dct00678/ALU-HALF/BOM.csv

Part Name | Quantity | Value | Description | Footprint | Datasheet | Avg Unit Price (USD) | Line Total (USD) | Avg Unit Price (PHP) | Line Total (PHP)
C1 | 1 | 220µF | Electrolytic capacitor, 16V, radial (bulk, +5V rail) |  |  | 0.25 | 0.25 | 15.50 | 15.50
C2,C3 | 2 | 0.1µF | Ceramic capacitor, 50V (decoupling) |  |  | 0.10 | 0.20 | 6.20 | 12.40
D1,D2 | 2 | LED Red 5mm | Red LED, 5mm (D1 = SUM, D2 = C_OUT) |  |  | 0.15 | 0.30 | 9.30 | 18.60
Q1,Q2 | 2 | PN2222A | NPN transistor, TO-92 (E-B-C pinout) | Package_TO_SOT_THT:TO-92_Inline | https://www.onsemi.com/pub/Collateral/PN2222-D.PDF | 0.30 | 0.60 | 18.60 | 37.20
R1,R2,R3,R4 | 4 | 20K Ω | Resistor 1/4W |  |  | 0.05 | 0.20 | 3.10 | 12.40
R5,R6 | 2 | 220 Ω | Resistor 1/4W |  |  | 0.05 | 0.10 | 3.10 | 6.20
SW1,SW2 | 2 | SS12F17 | SPDT slide switch (inputs A, B) |  |  | 0.85 | 1.70 | 52.70 | 105.40
U1 | 1 | 74LS86 | Quad 2-input XOR gate, DIP-14 | Package_DIP:DIP-14_W7.62mm | https://www.jameco.com/Jameco/Products/ProdDS/48098.pdf | 0.32 | 0.32 | 20.00 | 20.00
U2 | 1 | 74LS08 | Quad 2-input AND gate, DIP-14 | Package_DIP:DIP-14_W7.62mm | http://www.ti.com/lit/gpn/sn74LS08 | 0.32 | 0.32 | 20.00 | 20.00
TOTAL |  |  |  |  |  |  | 3.99 |  | 247.70
