dct00678/ALU-HALF/Schematic/half_adder.pdf

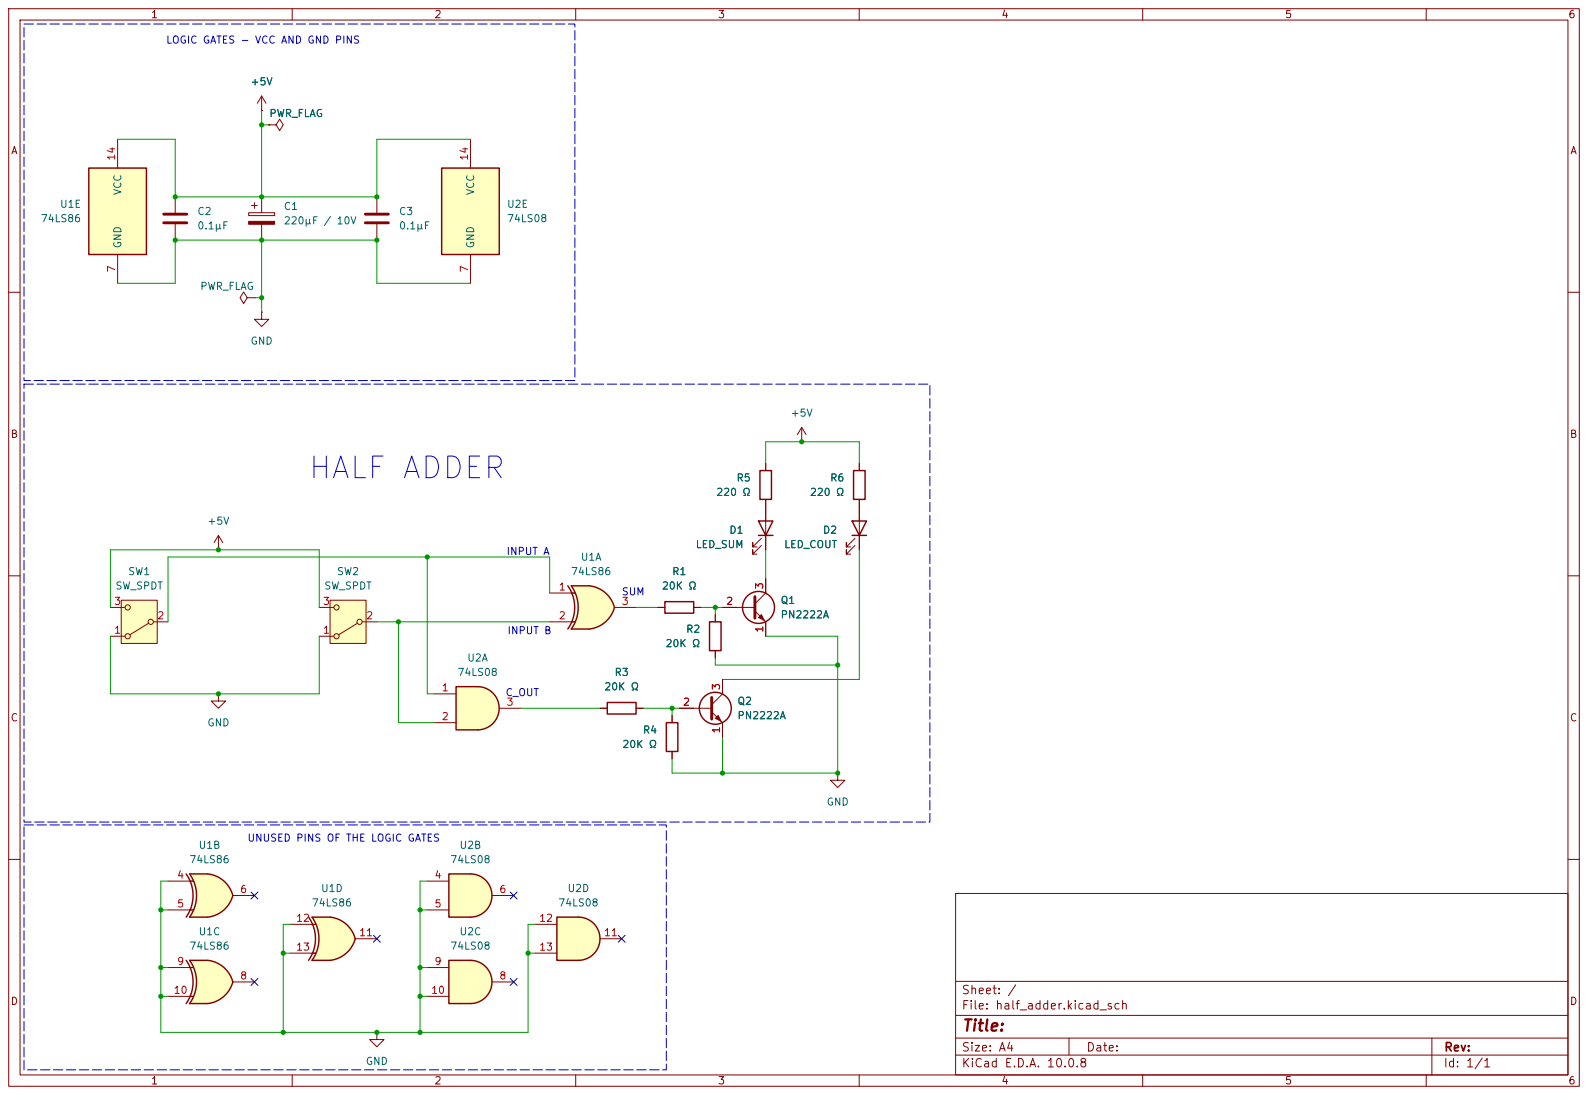
[picture p1: page 1]

LOGIC GATES - VCC AND GND PINS HALF ADDER

UNUSED PINS OF THE LOGIC GATES 6 U1B 74LS86 | 6 U2B

Size: A4 | Rev:
KiCad E.D.A. 10.0.8 | Id: 1/1
