dct00678/ALU-HALF/Schematic/half_adderrr.kicad_sch

## KiCad design Schematic/half_adderrr.kicad_sch (2026-11-11)

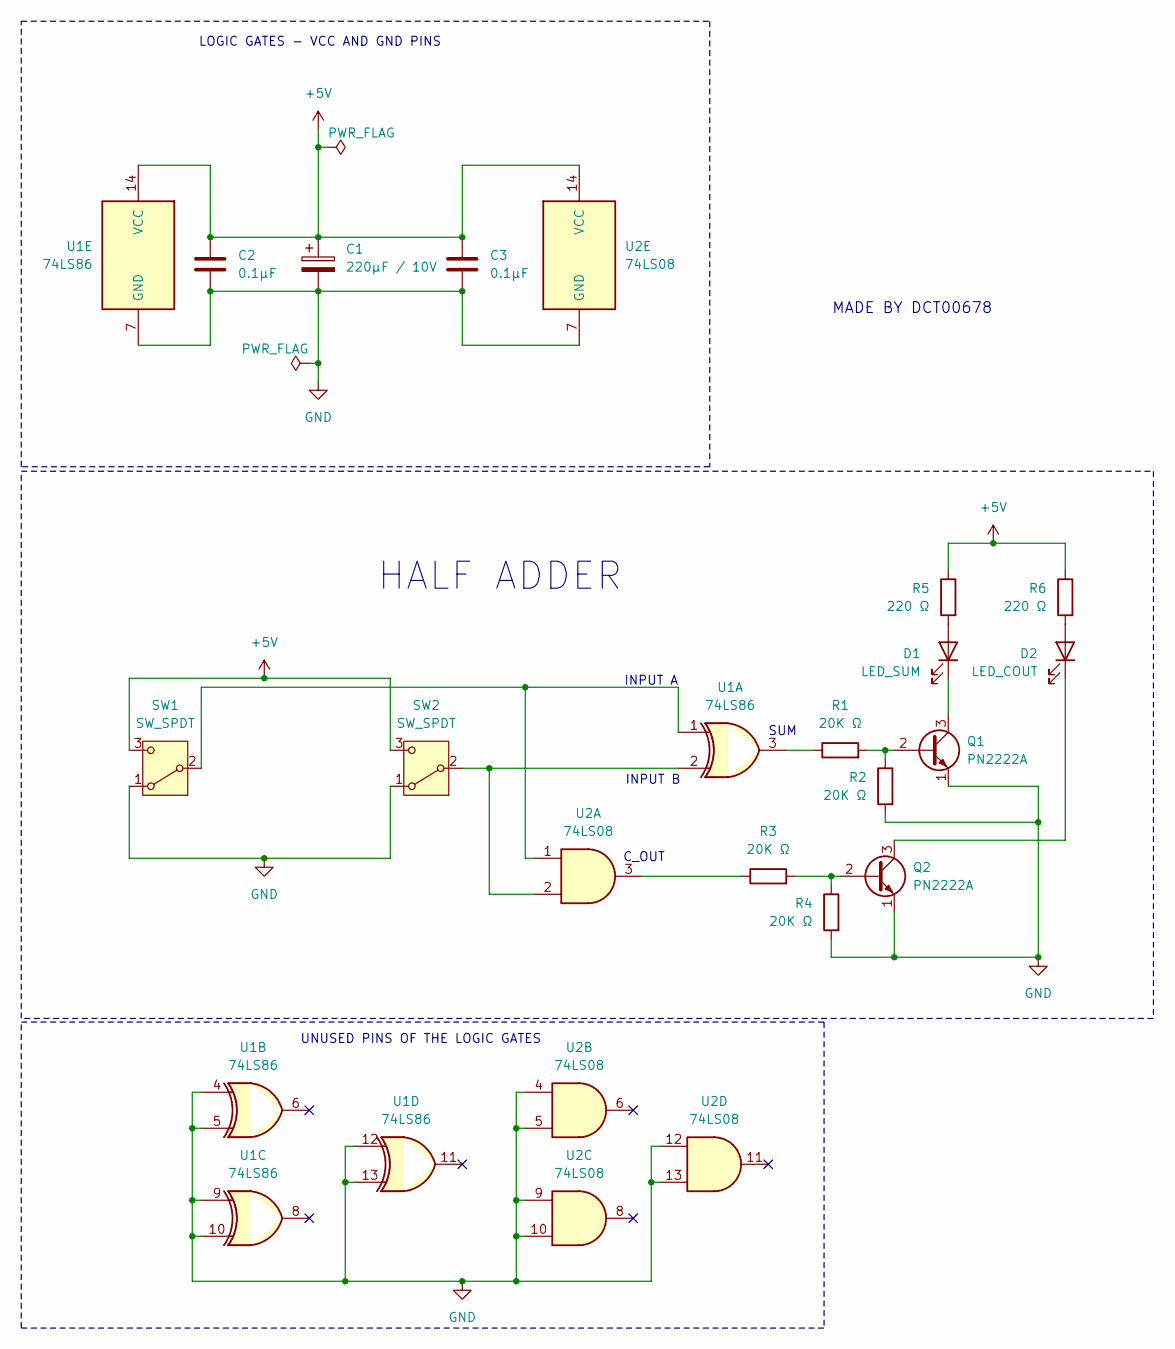
[picture p2: schematic half_adderrr.kicad_sch]

Parts:
C1: 220µF / 10V
C2, C3: 0.1µF
D1: LED_SUM
D2: LED_COUT
Q1, Q2: PN2222A; TO-92_Inline
R1, R2, R3, R4: 20K Ω
R5, R6: 220 Ω
SW1, SW2: SW_SPDT
U1: 74LS86
U2: 74LS08

Connections:
+5V: C1.1, C2.1, C3.1, R5.1, R6.1, SW1.3 (C), SW2.3 (C), U1.14 (VCC), U2.14 (VCC)
GND: C1.2, C2.2, C3.2, Q1.1 (E), Q2.1 (E), R2.2, R4.2, SW1.1 (A), SW2.1 (A), U1.4, U1.5, U1.7 (GND), U1.9, U1.10, U1.12, U1.13, U2.4, U2.5, U2.7 (GND), U2.9, U2.10, U2.12, U2.13
unnamed: D1.1 (K), Q1.3 (C)
unnamed: D1.2 (A), R5.2
unnamed: D2.1 (K), Q2.3 (C)
unnamed: D2.2 (A), R6.2
unnamed: Q1.2 (B), R1.2, R2.1
unnamed: Q2.2 (B), R3.2, R4.1
unnamed: R1.1, U1.3
unnamed: R3.1, U2.3
unnamed: SW1.2 (B), U1.1, U2.1
unnamed: SW2.2 (B), U1.2, U2.2

Notes on the sheet:
SUM
UNUSED PINS OF THE LOGIC GATES
HALF ADDER
MADE BY DCT00678
C_OUT
LOGIC GATES - VCC AND GND PINS
INPUT B
INPUT A
