dct00678/ALU-HALF/JOURNAL.md

---
title: ALU-HALF
author: dct00678
description: "Building a 74LS Half Adder: The Core Foundation of Modern Microcontrollers and ALUs"
created_at: 11-10-2026
---

# November 10 2026 / 🕗 8:20 - 8:40 PM
Started creating the schematic in KiCad cuz the last time that i was building schematics was in EasyEda and well it was REALLY bad!

Made the VCC AND GND connections of each Logic Gate, paired with a 0.1uf Capacitor. 
For the main breadboard power rails, i laid a 220uf / 10V capacitor to act as a bulk decoupling capacitor.

I paired the VCC and GND pins with a capacitor because my power supply is not stable it's being connected on my laptop so it's like a dc-dc, and it serves as a decoupling capacitor for low level voltage noises!

Note: Today i learned that we need to use pwr_flags for the vcc and gnd pin!!


**Total time spent: 20 Minutes**

# November 10 2026 / 🕣 8:45 - 8:50 PM
Added the switches for the inputs of the Half Adder
I used SPDT Switches so when a another person builds this, they can manually change the state of each input. (I HATE USING PUSHBUTTONS!!)

SW = Switches

SW1 = Input A
SW2= Input B



**Total time spent: 10 Minutes**

# November 10 2026 / 🕣 8:55 - 9:25 pm

Built the 74LS Logic Gates, had a little mix up on the wires but resolved within 2 minutes
Used 20k Resistors for the base of the transistors then connected another 20k from the base to GND.
From what i have experienced, it's to avoid floating pins



**Total time spent: 30 Minutes**

# November 10 2026 / 🕤 9:25 PM - 9:45 PM
Ran the Electrical Rules Checker, and i got a message / error of the VCC and GND pin of the 74LS86 has been reversed, but it was quickly solved.

I also added the unused pins of each logic gates, and each of their inputs is put on GND to avoid their interference with the used inputs and outputs (common practice for me)



**Total time spent: 20 Minutes**

# November 10 2026 / 🕤 9:50 PM : 11 PM
Assembly Time!

**THIS WILL ALSO BE A GUIDE FOR CREATING IT YOURSELF!!**

Get your breadboard and get the following:
1 74LS86N XOR GATE
1 74LS08N AND GATE
2 SPDT Switches
1 Electrolytic Capacitor | 220uf / 10V
2 Ceramic Capacitors | 0.1uf
Jumper Wires / Solid Core Wires



**1. Put your electrolytic capacitor close to the entry point of your power supply**



**2. Put your Logic Gates on the breadboard, XOR GATE FIRST, THEN THE AND GATE**



**3. Connect your ceramic capacitors, put it near and closest to the vcc and gnd pin like shown in the picture** 



**4. Connect the VCC and GND pins to each side of the ceramic capacitor, and wire it to the appropriate power supply


**5. Connect the switches on the breadboard** 


**Total time spent: 1 hour 10 minutes**

# Novemeber 11, 2026 | 🕠 5:30 PM - 6:30 PM
**6. Connect the switches to their appropriate logic gate inputs**

It should be this: 
OR follow the schematic diagram


CONTINUED THE NEXT DAY BECAUSE IT WAS NIGHT TIME AND I HAD SCHOOL

There was an error of my wiring of switches, turns out each Pin 1 and 3 both of the switches are connected to GND, and when i tested it the led flickered, but i fixed it. 
I also first wired the inputs to XOR Gate first then AND Gate, can be seen in 2nd pic

Wired the And Gate input and outputs, and also changed the length of the resistor legs

THE AND GATE WORKED!! 


**Total time: 1 hour**

Journal is now done thx you!! 
CTTO: https://www.geeksforgeeks.org/digital-logic/implementation-of-full-adder-using-half-adders/#what-is-half-adder

**Total time spent: 30 Minutes**
