dct00678/ALU-HALF/(commit log)

2026-11-10 Extra Details
    Expanded project description and clarified functionality of the Half Adder circuit.
2026-11-10 Revise JOURNAL.md with project details and assembly guide
2026-11-10 Final Commit
    Updated instructions for connecting switches to logic gates and added a reference link.
2026-11-10 Update journal entry with assembly time duration
2026-11-11 Enhance journal entry with wiring details and images
    Updated journal entry with additional details about connecting switches and wiring the AND gate. Included images and noted completion of the journal.
2026-11-11 Add demo video link to README
    Added a demo video link for the AND Gate circuit.
2026-11-11 Add BOM.csv with component details
    [BOM.csv]
2026-11-11 Update BOM.csv header and format
    [BOM.csv]
2026-11-11 Update BOM.csv with pricing information
    Added average unit price and line total columns to BOM.
    [BOM.csv]
2026-11-11 Add PHP pricing columns to BOM.csv
    Added average unit price and line total in PHP for each part.
    [BOM.csv]
2026-11-11 Create Schematic
2026-11-11 Upload PDF of Schematic
